maxime22-origine/Agro-rover_agricole/simulation/agrover_cinematique.pdf

## AGROVER MR 25.26 — Modele Cinematique : Robot Skid-Steer 4 Roues

JUNIA HEI4 MR 2025-2026 • SAGNA Mouhamadou Bassirou / NGON Vinny Juniors

### 1. Modele geometrique — representation dans le repere global (X_G, Y_G)

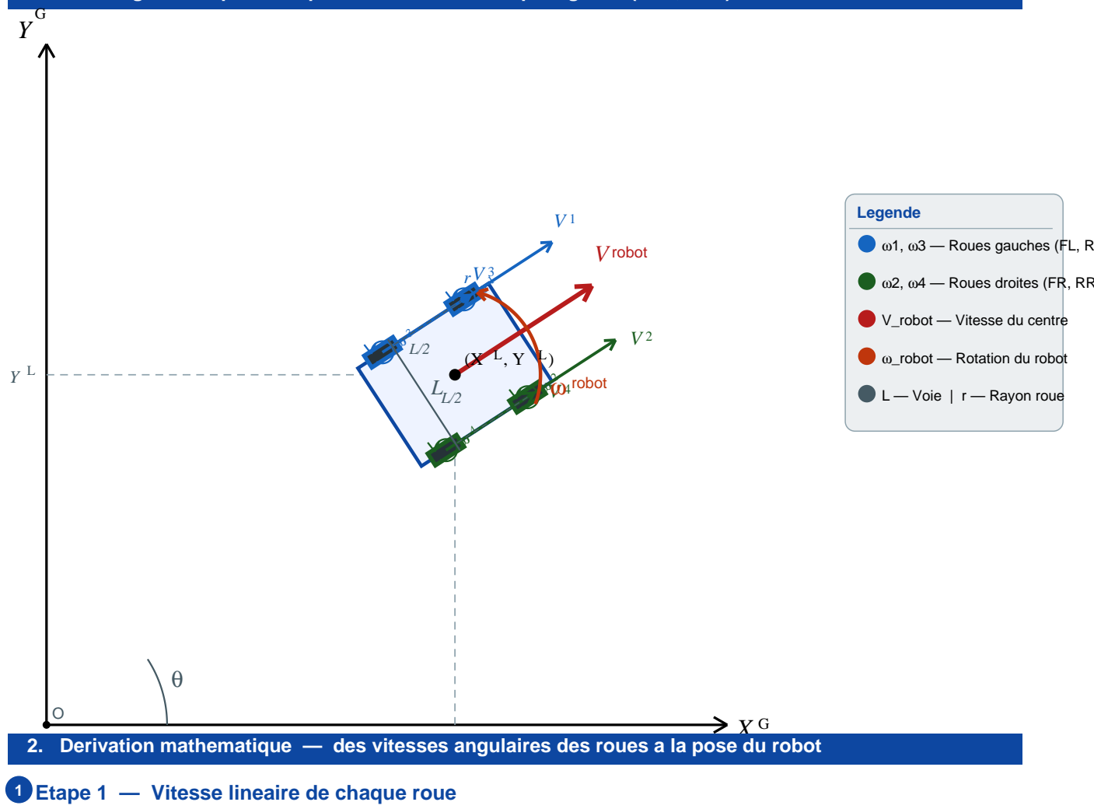
[picture p3: figure]
Vrobot; ω robot; Legende; ω1, ω3 — Roues gauches (FL, RL); ω2, ω4 — Roues droites (FR, RR); V_robot — Vitesse du centre; ω_robot — Rotation du robot; L — Voie | r — Rayon roue

### 2. Derivation mathematique — des vitesses angulaires des roues a la pose du robot

### 1 Etape 1 — Vitesse lineaire de chaque roue

Chaque moteur Dynamixel XL430 tourne a la vitesse angulaire wi (rad/s).
La vitesse lineaire de la jante vaut :
v_i = r . w_i | (m/s) | avec r = rayon de la roue (m)
Pour le robot a 4 roues, on calcule la vitesse moyenne de chaque cote :
v_gauche = r . (w_1 + w_3) / 2 | (moyenne roues FL et RL)
v_droite = r . (w_2 + w_4) / 2 | (moyenne roues FR et RR)

### 2 Etape 2 — Vitesse lineaire et angulaire du robot

Le centre du robot se deplace a la vitesse moyenne des deux cotes. La difference
de vitesse entre droite et gauche provoque la rotation :
v_robot = (v_droite + v_gauche) / 2 | (vitesse lineaire au centre [m/s])
w_robot = (v_droite - v_gauche) / L | (vitesse angulaire [rad/s])
avec L = voie du robot (distance entre les centres de roues gauche et droite)
AGROVER MR 25.26 — Modele Cinematique | 1 / 2

## AGROVER MR 25.26 — Modele Cinematique : Robot Skid-Steer 4 Roues

JUNIA HEI4 MR 2025-2026 • SAGNA Mouhamadou Bassirou / NGON Vinny Juniors

### 2. Derivation mathematique (suite) — Equation de la pose

### 3 Etape 3 — Centre Instantane de Rotation (CIR)

Lorsque v_droite ≠ v_gauche, le robot decrit un arc de cercle autour du CIR.
Le rayon de courbure R est :
R = v_robot / w_robot = L/2 . (v_droite + v_gauche) / (v_droite - v_gauche) Cas particuliers importants :
- v_d = v_g => R = infini => deplacement en ligne droite
- v_d = -v_g => R = 0 => rotation sur place (pivot)

### 4 Etape 4 — Equation differentielle de la pose

La pose du robot est le triplet q(t) = (x(t), y(t), θ(t)) dans le repere global. En derivant par rapport au temps, on obtient le systeme differentiel : x'(t) = v_robot(t) . cos( θ(t) )
y'(t) = v_robot(t) . sin( θ(t) )
θ'(t) = w_robot(t)
ou v_robot et w_robot sont calcules a partir des encodeurs (voir Etapes 1 et 2).

### 5 Etape 5 — Integration numerique (Euler modifie)

En continu, l'integration exacte est difficile. On discretise en pas de temps dt. A chaque iteration k, les increments de deplacement et d'orientation sont :
∆s | = v_robot . dt | (distance parcourue en dt)
∆θ | = w_robot . dt | (variation d'orientation en dt)
L'Euler modifie (point milieu) utilise l'angle a mi-pas (θ + ∆θ/2),
ce qui reduit l'erreur d'accumulation par rapport a l'Euler simple.

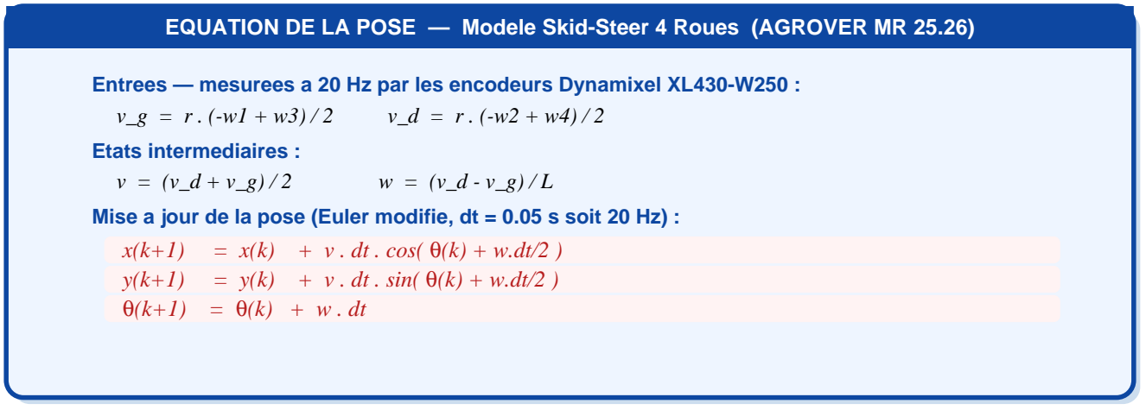
[picture p4: figure]
Etats intermediaires :

EQUATION DE LA POSE — Modele Skid-Steer 4 Roues (AGROVER MR 25.26)

Entrees — mesurees a 20 Hz par les encodeurs Dynamixel XL430-W250 :
v_g = r . (-w1 + w3) / 2 v_d = r . (-w2 + w4) / 2

Mise a jour de la pose (Euler modifie, dt = 0.05 s soit 20 Hz) : x(k+1) = x(k) + v . dt . cos( θ(k) + w.dt/2 )
y(k+1) = y(k) + v . dt . sin( θ(k) + w.dt/2 )

Remarque : ce modele suppose un roulement sans glissement lateral. En pratique le glissement lateral (inherent au skid-steer) introduit une derive odometrique qui est corrigee par le filtre AMCL de Nav2 via le recalage sur la carte LiDAR (RPLIDAR A1, 8 m de portee).

AGROVER MR 25.26 — Modele Cinematique | 2 / 2
