maxime22-origine/Agro-rover_agricole/simulation/images/avancer.jpg

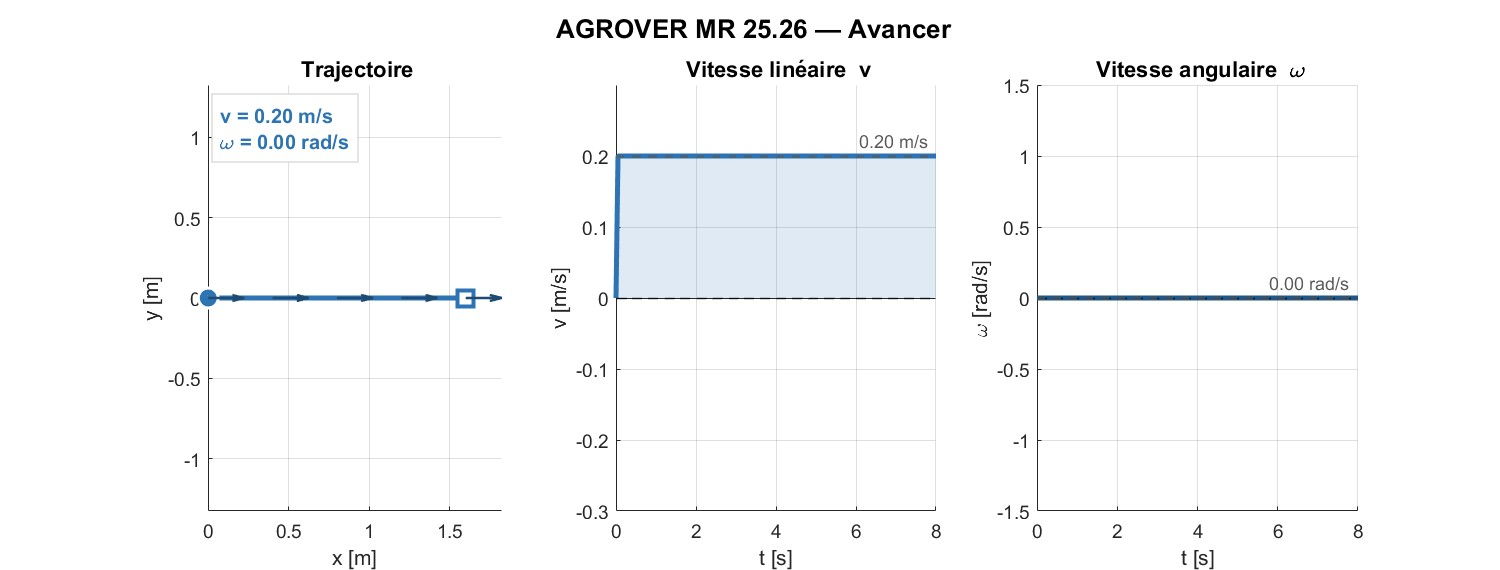
simulation/images/avancer.jpg
