maxime22-origine/Agro-rover_agricole/simulation/images/pivot_droite.jpg

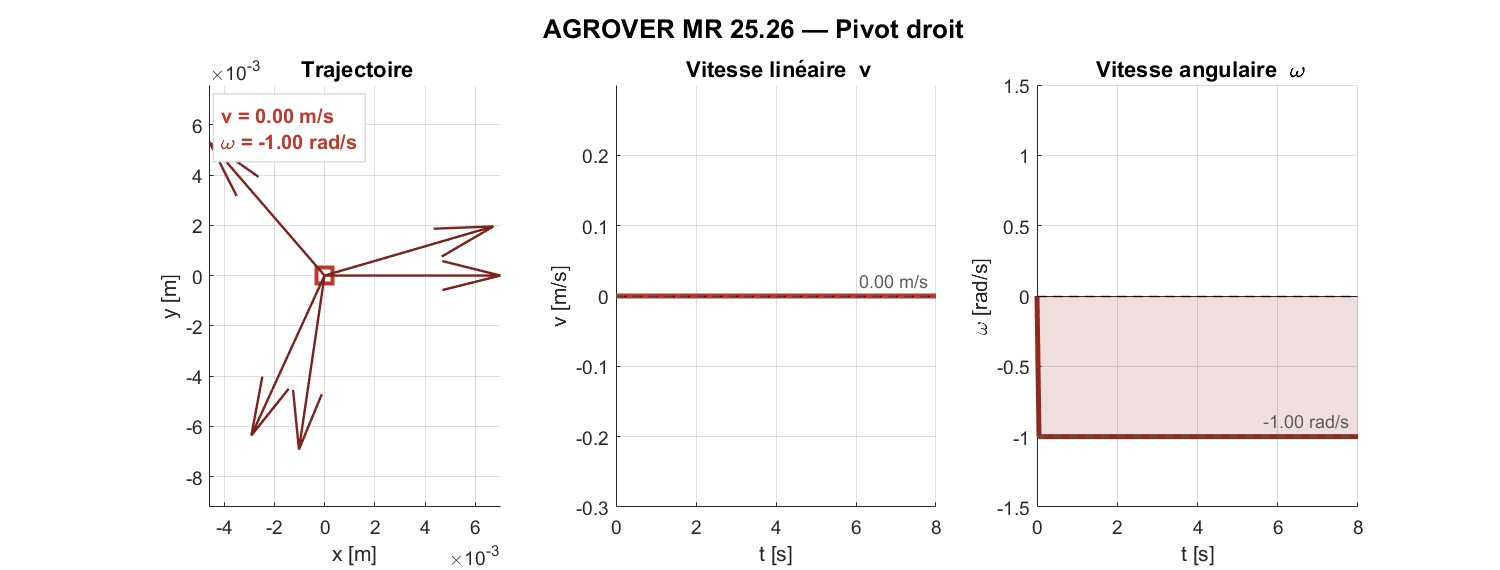
simulation/images/pivot_droite.jpg
