maxime22-origine/Agro-rover_agricole/simulation/images/pivot_gauche.jpg

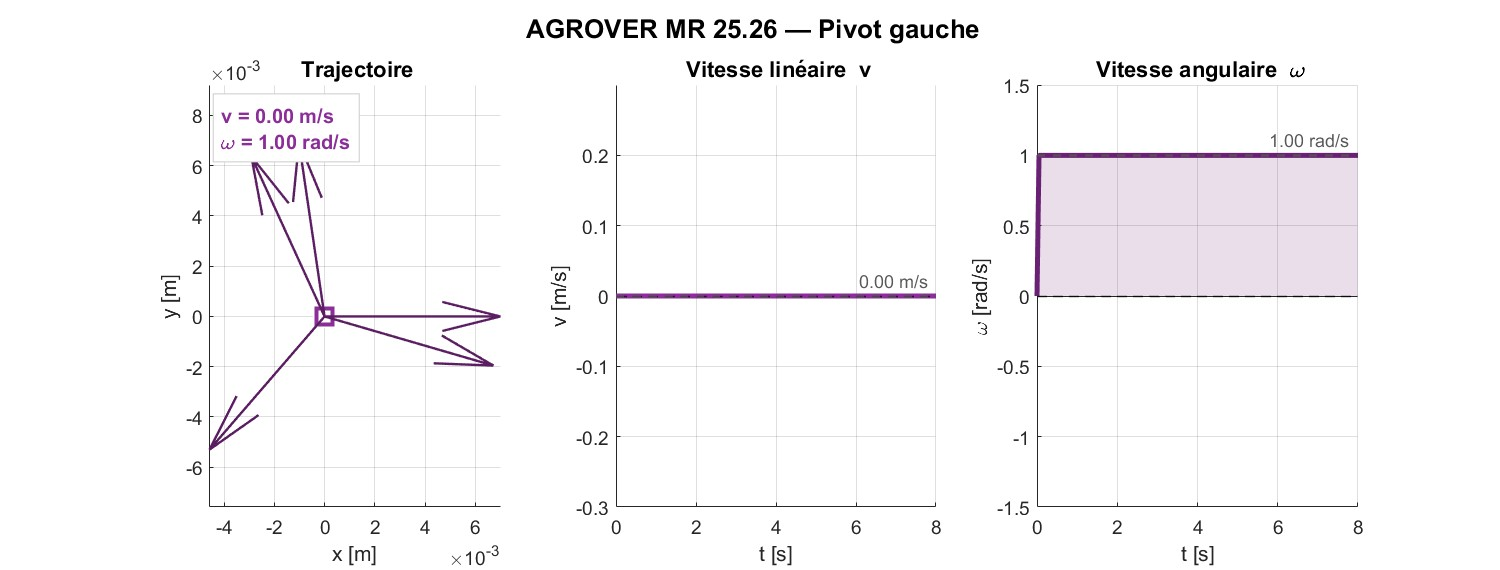
simulation/images/pivot_gauche.jpg
