maxime22-origine/Agro-rover_agricole/simulation/images/reculer.jpg

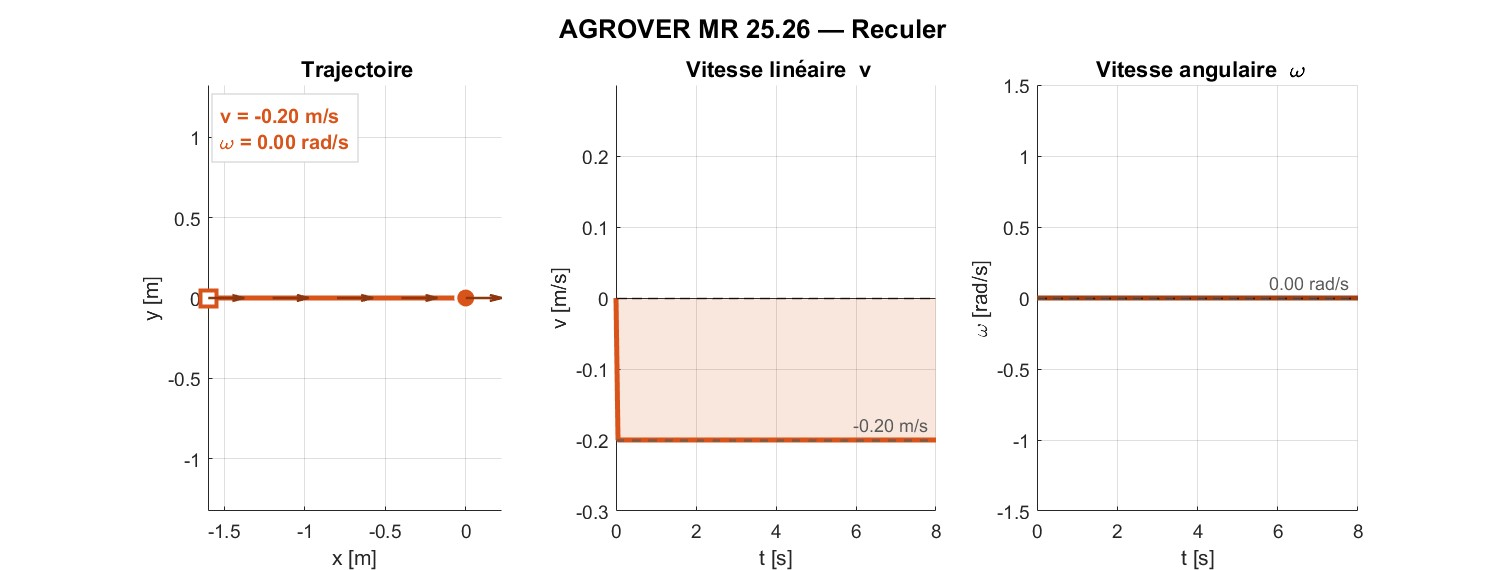
simulation/images/reculer.jpg
