maxime22-origine/Agro-rover_agricole/simulation/images/tourner_droite.jpg

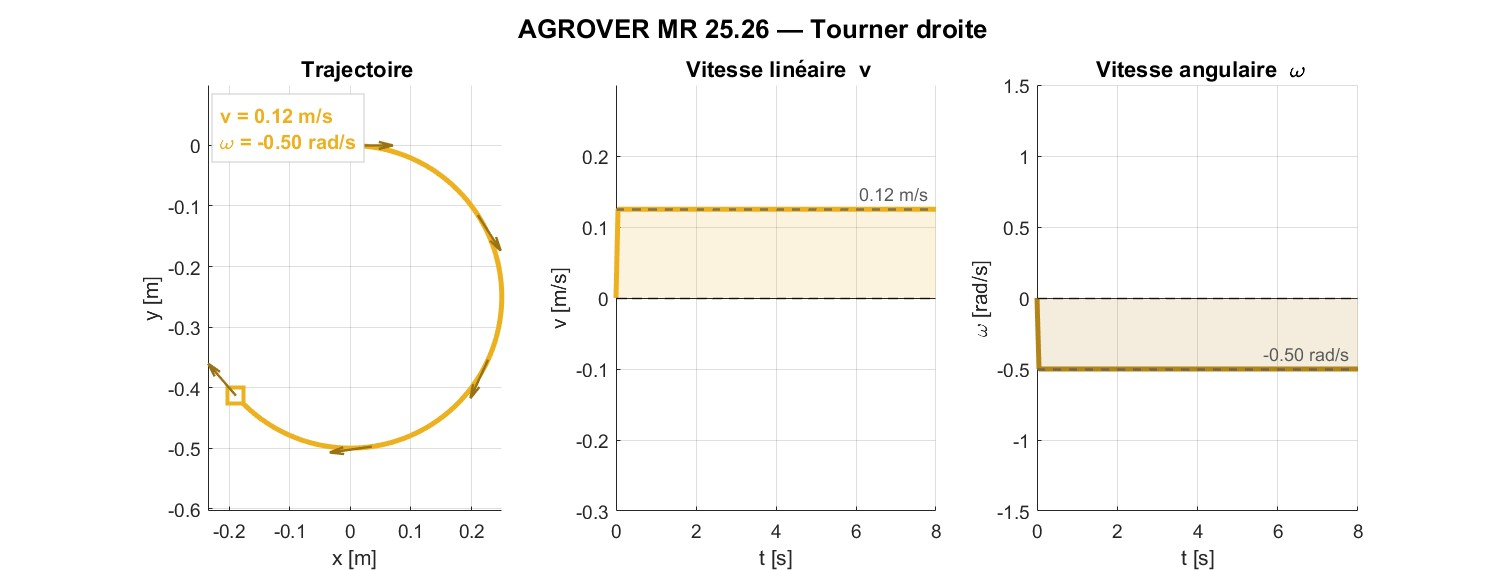
simulation/images/tourner_droite.jpg
